Crafitys/Crafitys_Glados/docs/assembly/Original_Shopping_List.pdf

Article | Qty | link
kit screw CHC | | | | | | | | | 1 https://www.amazon.fr/Vwoqiy-hexagonale-cylindrique-rondelles-filetage/dp/B0DGGG3LJ4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
kit 50x Insert M4 | | | | | | | | | 1 https://www.amazon.fr/RX-M4x6-3-douilles-plastique-ultrasons-dimprimante/dp/B07YSV66Y5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
kit 50x Insert M5 | | | | | | | | | 1 https://www.amazon.fr/RX-M4x6-3-douilles-plastique-ultrasons-dimprimante/dp/B07YSVXWS8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
kit 2x Servo 15kg | 1 https://www.amazon.fr/diymore-servomoteurs-num%C3%A9riques-h%C3%A9licopt%C3%A8re-Voiture/dp/B09KZ8VTNB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 Red led | 1 https://www.amazon.fr/%C3%A9lectroluminescente-luminosit%C3%A9-multicolore-scientifiques-%C3%A9lectronique/dp/B0C3VGHGR1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 Round screend GC9A01 | 1 https://www.amazon.fr/dp/B0CFXVD9HX?ref=ppx_yo2ov_dt_b_fed_asin_title ESP32 C3 super mini | 1 https://www.amazon.fr/DUBEUYEW-D%C3%A9veloppement-ESP32-C3-Bluetooth-Compatible/dp/B0DMNBWTFD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 Kit 10x bearing F688ZZ | 1 https://www.amazon.fr/Roulements-Roulement-cessoire-roulement-epaulement/dp/B094NL7MDS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 Nema 17 | 1 https://www.amazon.fr/STEPPERONLINE-bipolaire-connecteur-imprimante-fraiseuse/dp/B0B38GX54H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 Kit 5x poulie GT2 | 1 https://www.amazon.fr/Lot-poulies-GT2-distribution-applications/dp/B0H3HK3JTX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 Profilé aluminium 2020 (750mm needed) | 1 https://www.amazon.fr/QWORK%C2%AE-daluminium-europ%C3%A9enne-imprimantes-fabrication/dp/B0G3WY1KL1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 Kit 2x taraud M5 | 1 https://www.amazon.fr/AzureRay-Hexagonal-M%C3%A9tallique-Inoxydable-Hexagonale/dp/B0F6MLD36Y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
kit 20x equerre 2020 | 1 https://www.amazon.fr/Connecteurs-Aluminium-20x20mm-%C3%89querre-Fixation/dp/B0GY8RY9CW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 A4988 driver | 1 https://www.amazon.fr/WJMY-Stepper-Driver-Radiateur-Imprimante/dp/B08R64Y7V7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
250x plastic screw 2x6 | | 1 https://www.amazon.fr/QUARKZMAN-Autotaraudeuses-Phillips-Cloison-Plastique/dp/B0CH9ZXMSK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
kit 20x M8x40 avec écrou | | 1 https://www.amazon.fr/Ensemble-inoxydable-Bouton-hexagonale-%C3%A9crous/dp/B09V4XTDTB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
kit 5x courroie GT2 300mm | | 1 https://www.amazon.fr/QUARKZMAN-Courroie-Distribution-Impression-Caoutchouc/dp/B0G712L3TR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
