Crafitys/Crafitys_Glados/docs/assembly/Glados_Assembly_Instructions.pdf

# Crafitys Glados

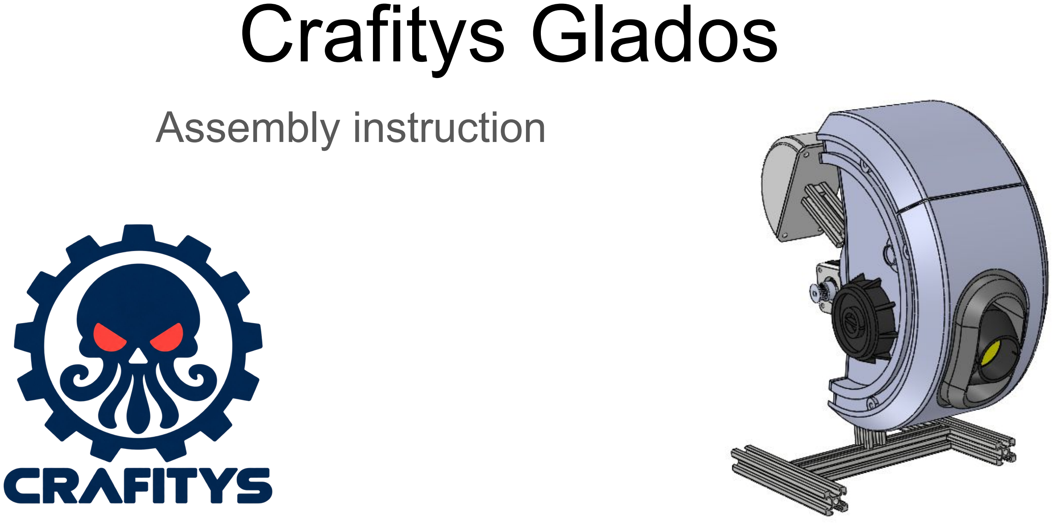
[picture p3: page 1]

# Assembly instruction

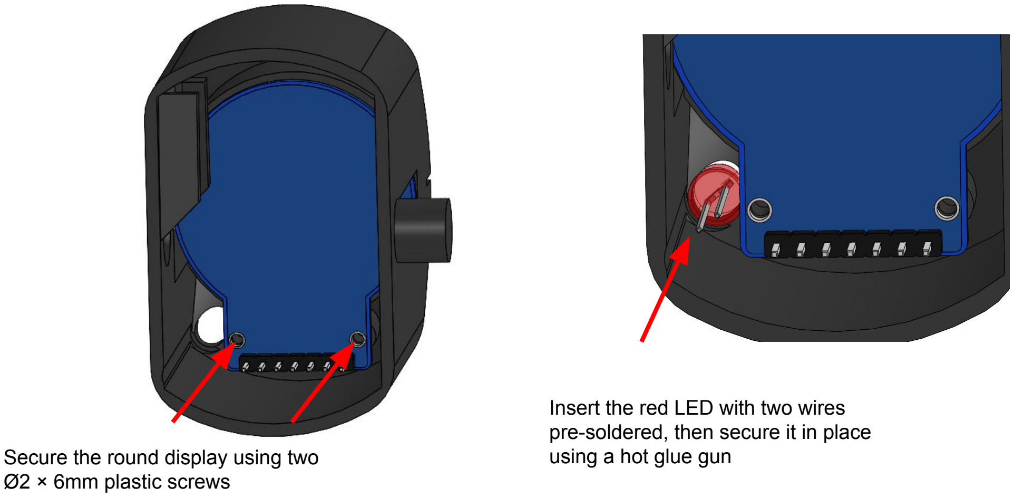
[picture p4: page 2]

Secure the round display using two Ø2 × 6mm plastic screws

Insert the red LED with two wires pre-soldered, then secure it in place using a hot glue gun

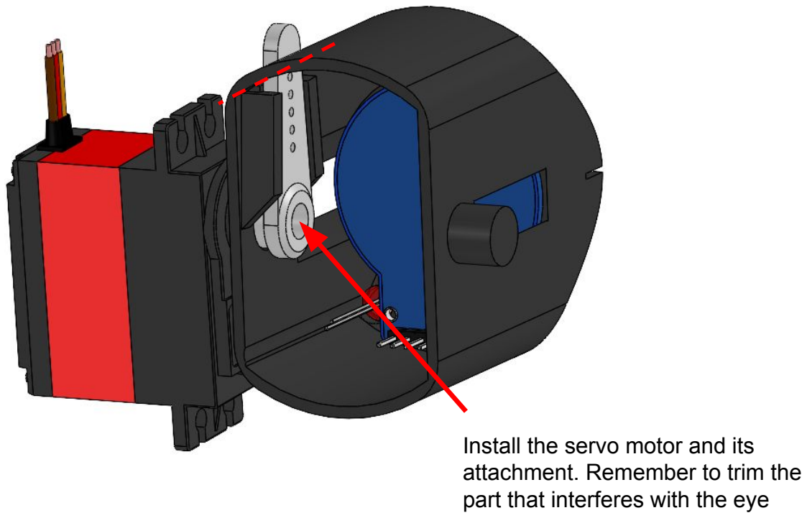
[picture p5: page 3]

Install the servo motor and its attachment. Remember to trim the part that interferes with the eye

Install the assembly into the ‘Eye

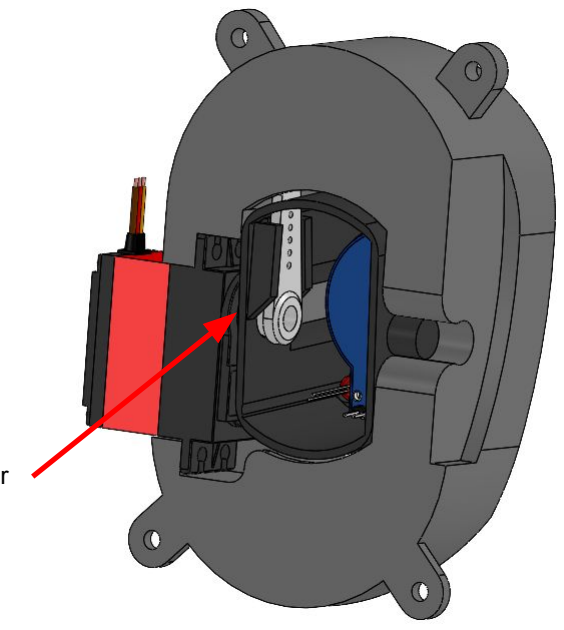
[picture p6: figure]

Support’ part and secure the motor in place

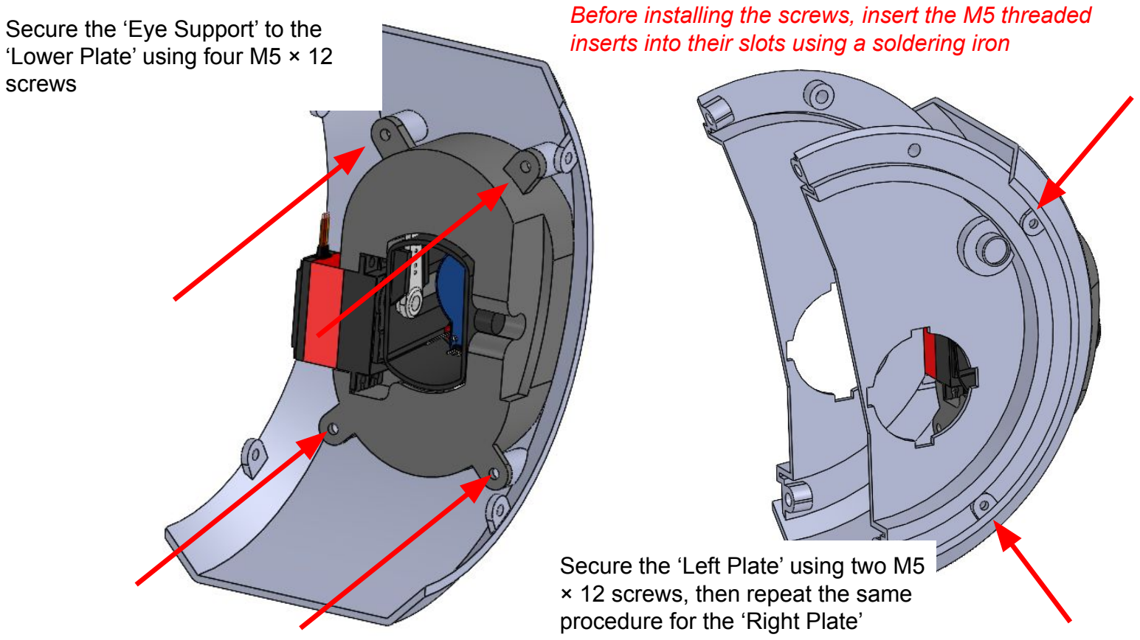
[picture p7: page 5]

Secure the ‘Eye Support’ to the ‘Lower Plate’ using four M5 × 12 screws

Secure the ‘Left Plate’ using two M5 × 12 screws, then repeat the same procedure for the ‘Right Plate’

Before installing the screws, insert the M5 threaded inserts into their slots using a soldering iron

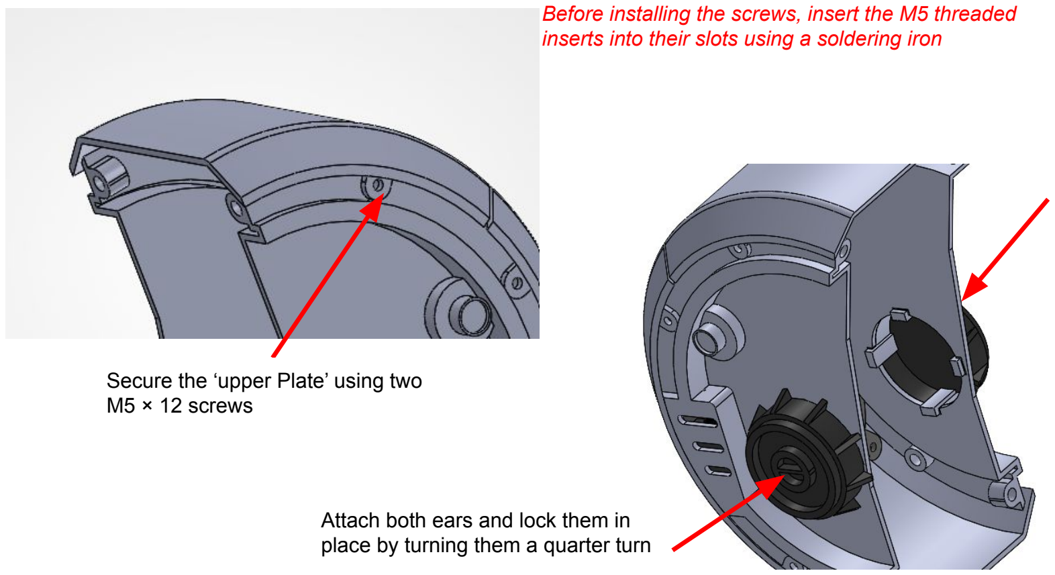
[picture p8: page 6]

Before installing the screws, insert the M5 threaded inserts into their slots using a soldering iron

Secure the ‘upper Plate’ using two M5 × 12 screws

Attach both ears and lock them in place by turning them a quarter turn

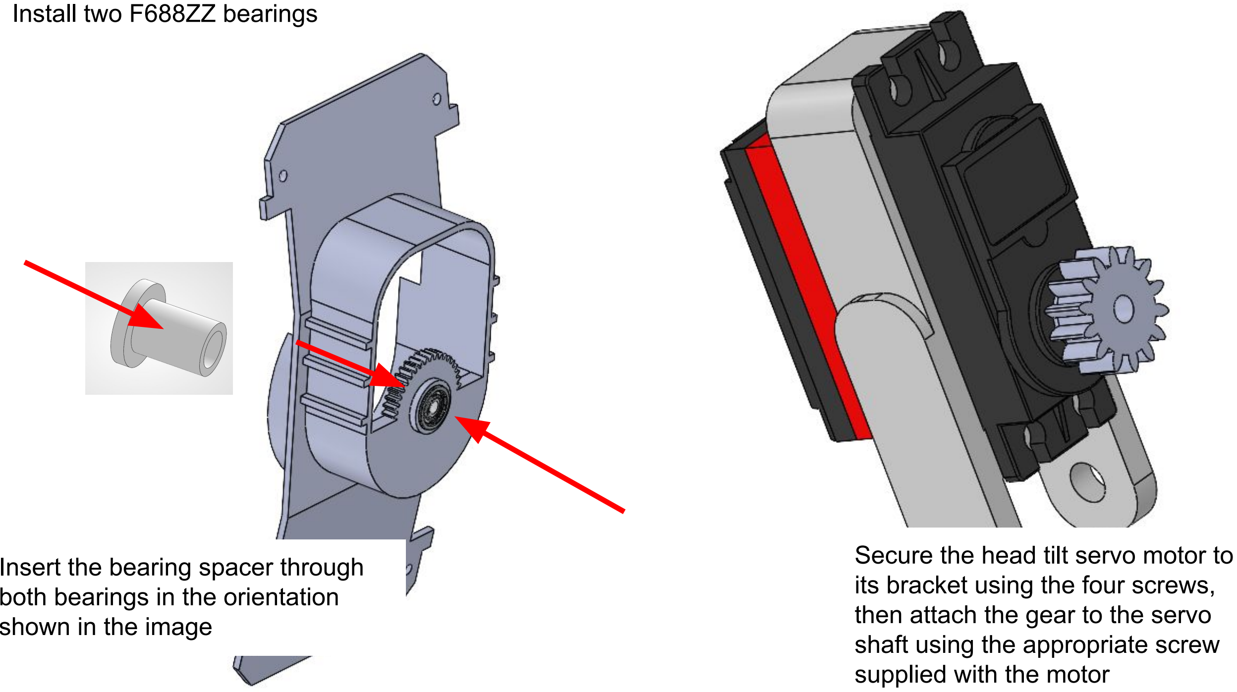
[picture p9: page 7]

Install two F688ZZ bearings

Secure the head tilt servo motor to its bracket using the four screws, then attach the gear to the servo shaft using the appropriate screw supplied with the motor

Insert the bearing spacer through both bearings in the orientation shown in the image

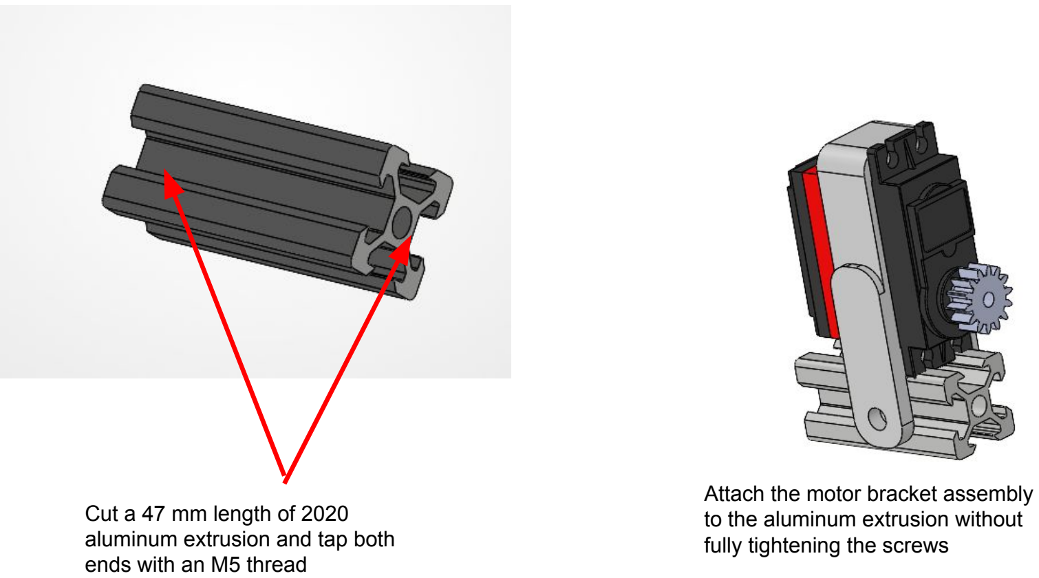
[picture p10: page 8]

Cut a 47 mm length of 2020 aluminum extrusion and tap both ends with an M5 thread

Attach the motor bracket assembly to the aluminum extrusion without fully tightening the screws

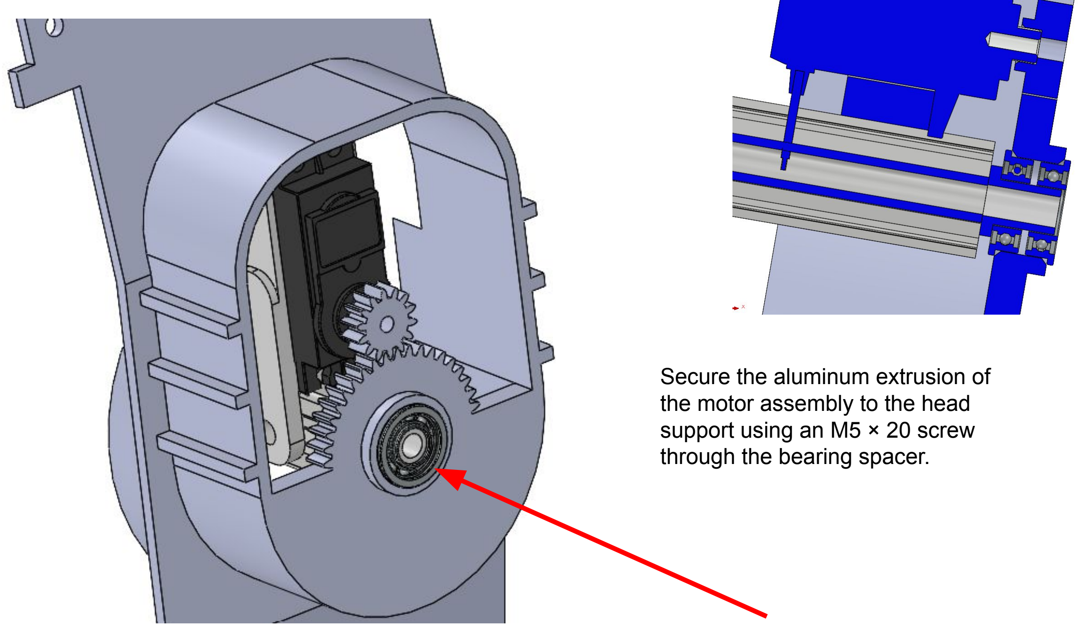
[picture p11: page 9]

Secure the aluminum extrusion of the motor assembly to the head support using an M5 × 20 screw through the bearing spacer.

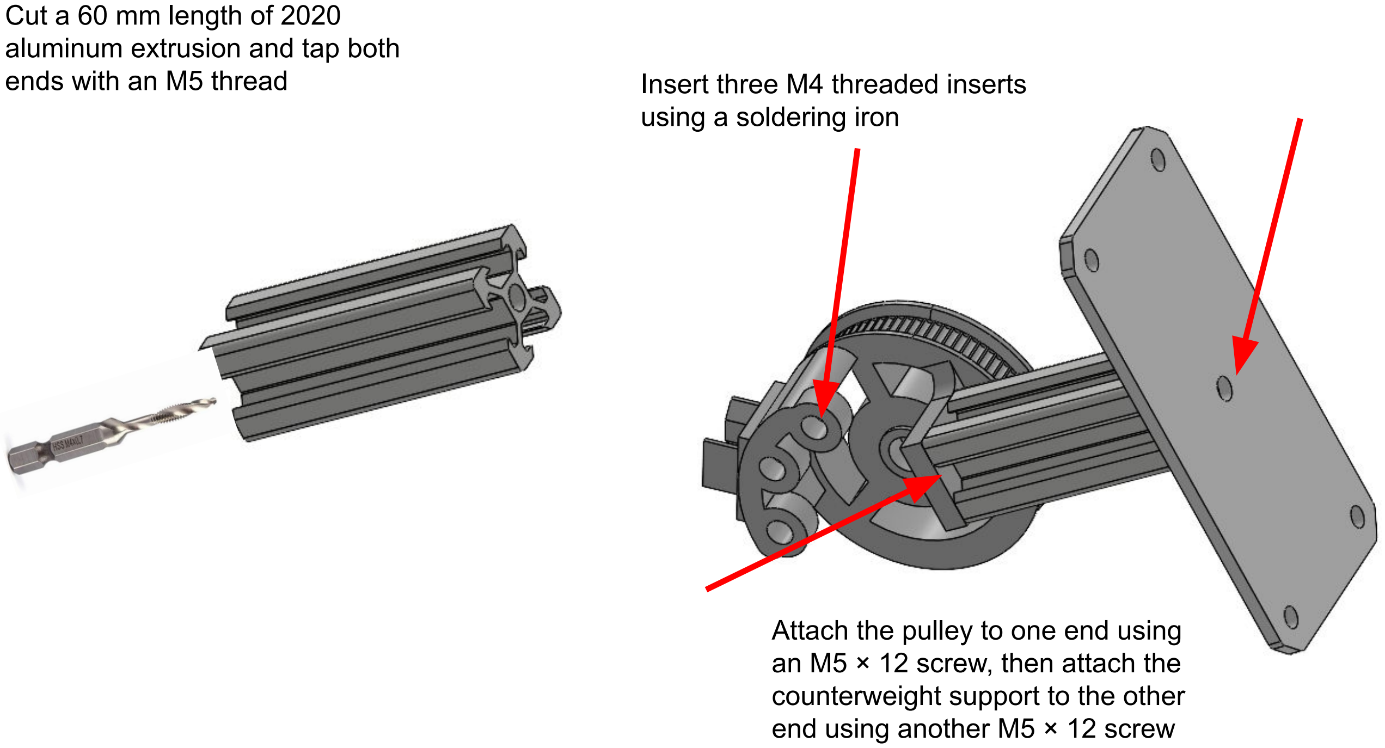
[picture p12: page 10]

Cut a 60 mm length of 2020 aluminum extrusion and tap both ends with an M5 thread

Attach the pulley to one end using an M5 × 12 screw, then attach the counterweight support to the other end using another M5 × 12 screw

Insert three M4 threaded inserts using a soldering iron

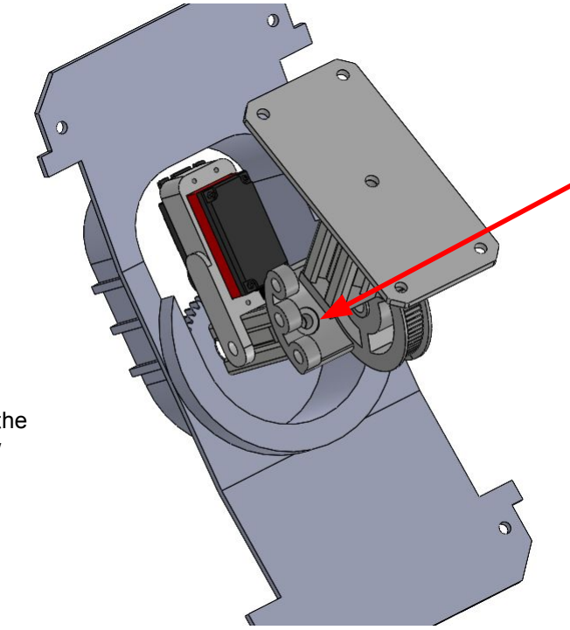
[picture p13: figure]

Secure the head assembly to the pulley using an M5 × 12 screw

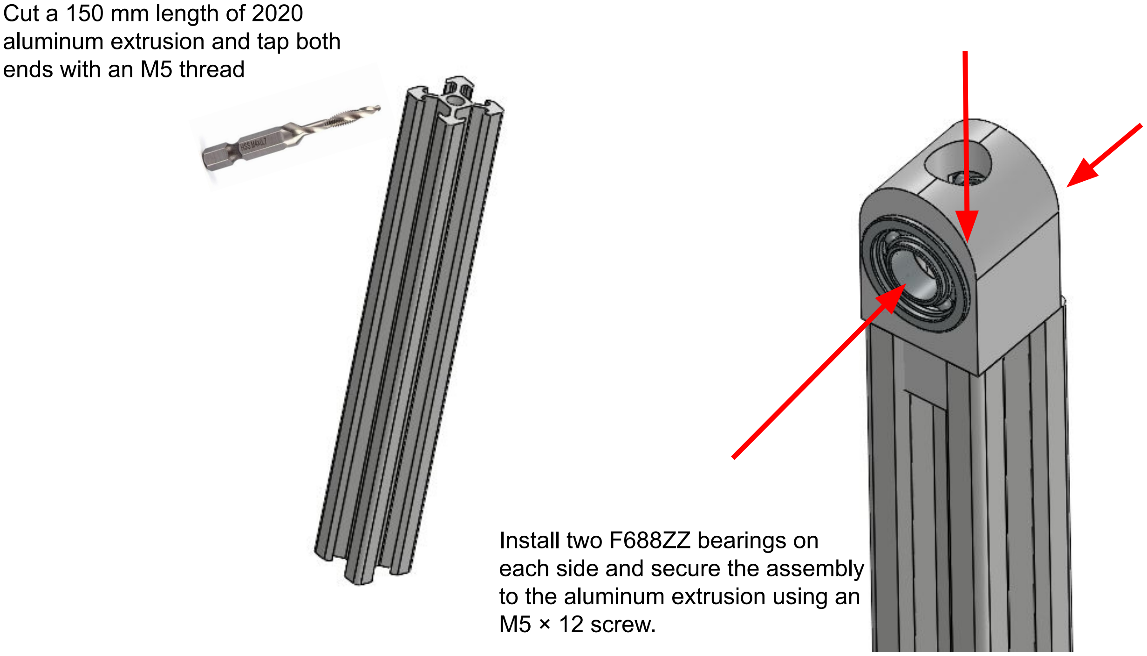
[picture p14: page 12]

Cut a 150 mm length of 2020 aluminum extrusion and tap both ends with an M5 thread

Install two F688ZZ bearings on each side and secure the assembly to the aluminum extrusion using an M5 × 12 screw.

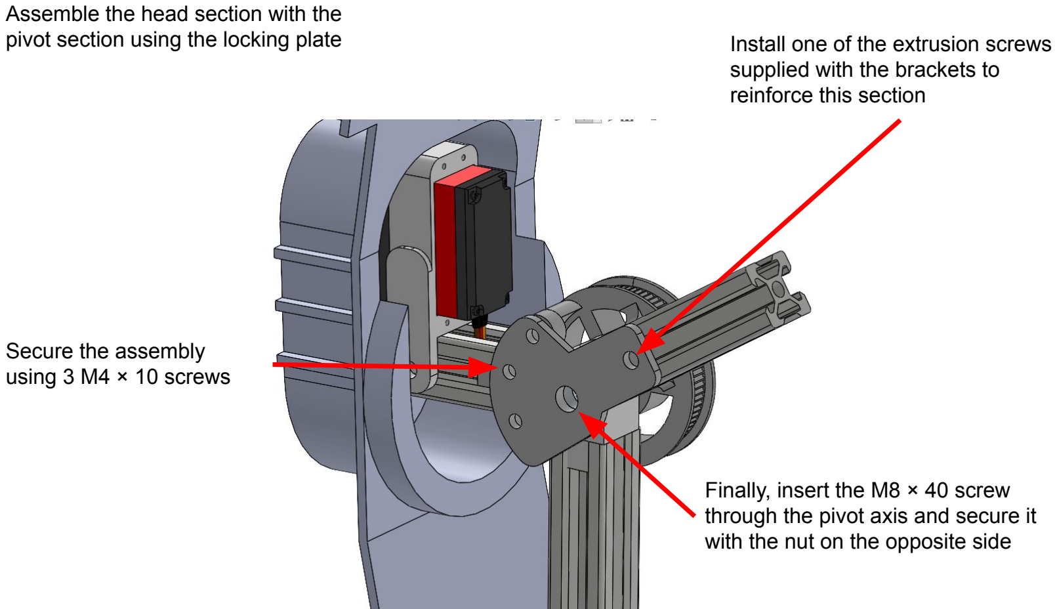
[picture p15: page 13]

Assemble the head section with the pivot section using the locking plate

Secure the assembly
using 3 M4 × 10 screws

Install one of the extrusion screws supplied with the brackets to reinforce this section

Finally, insert the M8 × 40 screw through the pivot axis and secure it with the nut on the opposite side

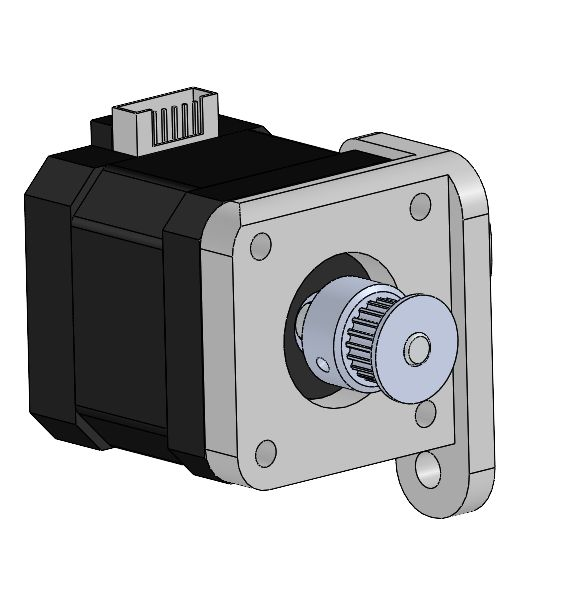
[picture p16: figure]

Secure the NEMA 17 motor to the NEMA motor bracket using four M3 × 16 screws, then attach the pulley to the motor shaft.

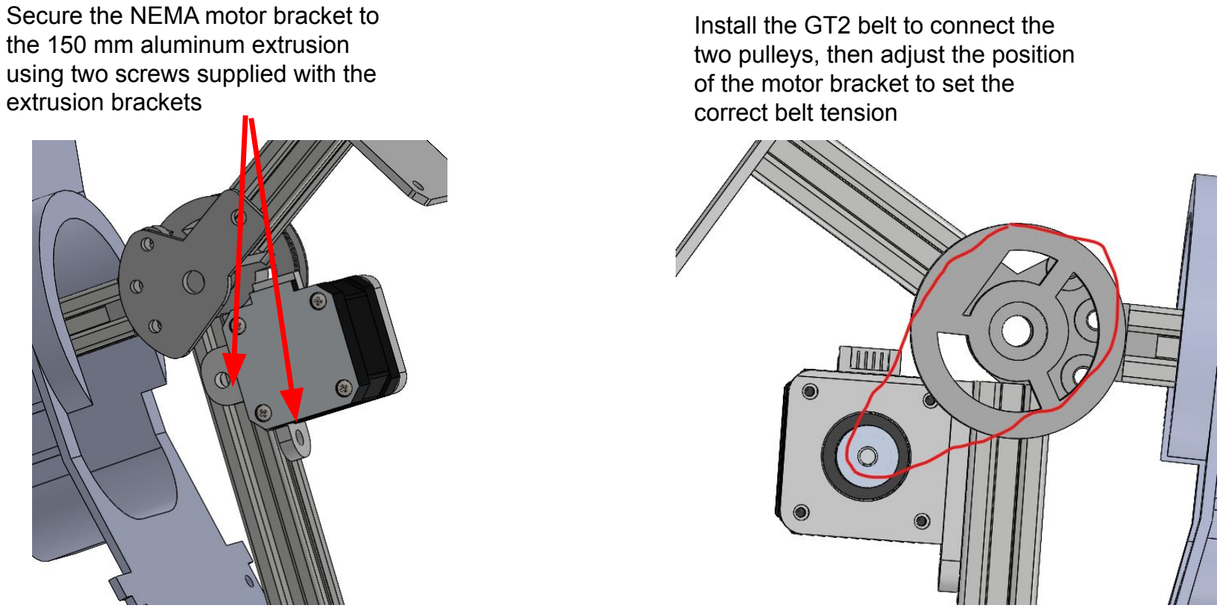
[picture p17: page 15]

Secure the NEMA motor bracket to the 150 mm aluminum extrusion using two screws supplied with the extrusion brackets

Install the GT2 belt to connect the two pulleys, then adjust the position of the motor bracket to set the correct belt tension

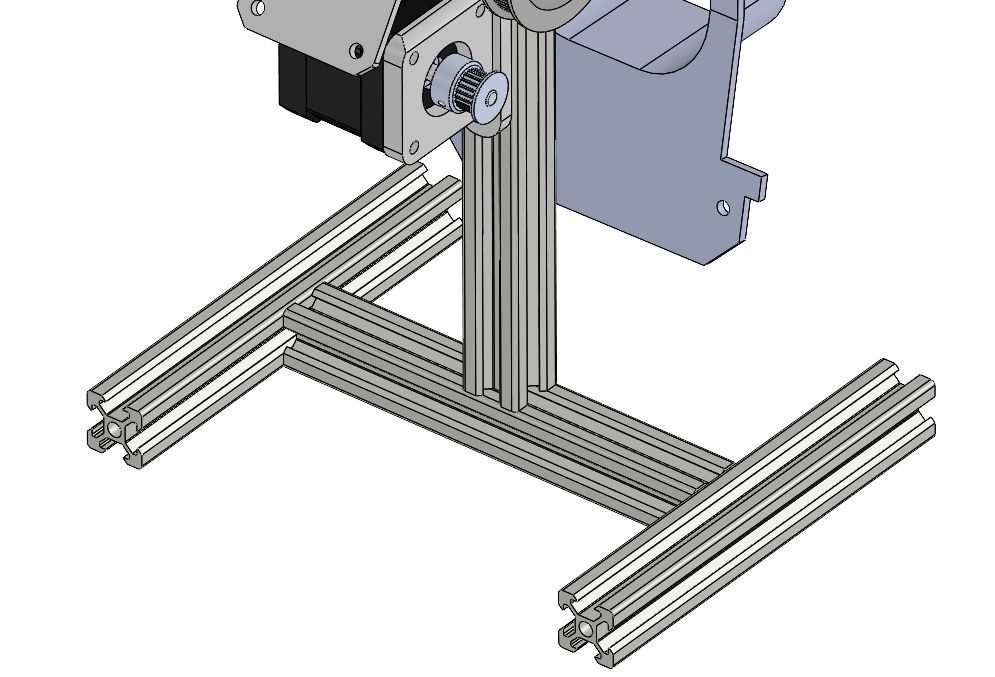
[picture p18: figure]

Assemble the base as shown in the image below using aluminum extrusions and brackets

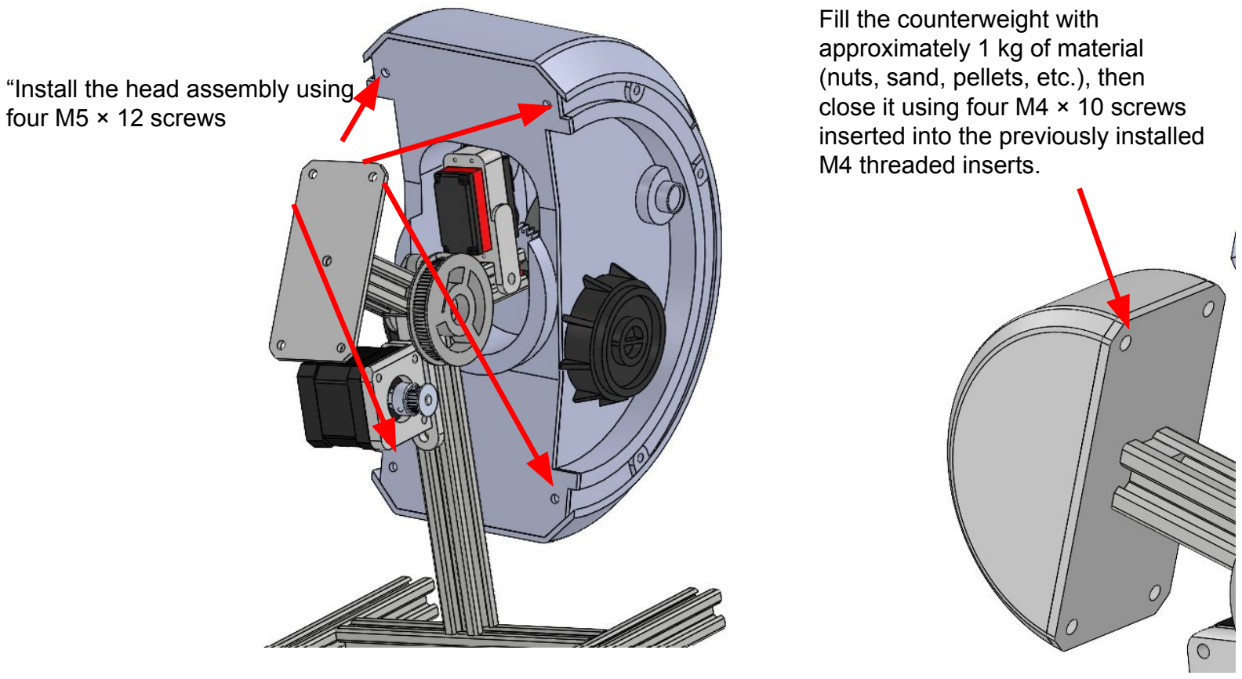
[picture p19: page 17]

“Install the head assembly using four M5 × 12 screws

Fill the counterweight with approximately 1 kg of material (nuts, sand, pellets, etc.), then close it using four M4 × 10 screws inserted into the previously installed M4 threaded inserts.

# Your GLaDOS is now fully assembled!

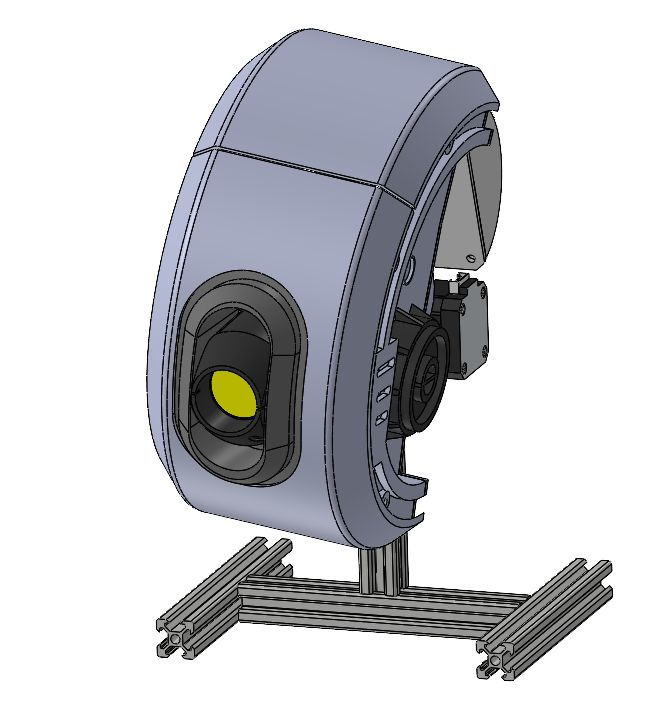
[picture p20: figure]
