Crafitys/Crafitys_Glados/requirements-validated.txt

# Direct dependency versions used for software checks on Linux / Python 3.12.
# This is not a complete transitive lockfile.
numpy==2.5.4
requests==2.34.2
pyserial==3.5
sounddevice==0.5.6
soundfile==0.14.0
webrtcvad-wheels==2.0.14.post1
faster-whisper==1.2.1
piper-tts==1.8.0
