Crafitys/Crafitys_Glados/(commit log)

2026-10-11 Add complete GLaDOS software, ESP32-C3 firmware and English build guides
2026-10-11 Add electrical parts list and basic A4988 wiring diagram
2026-10-11 Show component wiring and separate USB, 24 V and servo power paths
2026-10-11 Add complete linked BOM and assembly manual with original Crafitys cover artwork
